lizDenny/Capstone-Flood-Monitor/README.md

# Capstone Flood Monitor
Three different licenses are used, each for different portions of the repo. Firmware and software files are covered under MIT. Hardware files like pcb and enclosure designs are covered under CERN-OHL-P-2.0. Documentation files like schematics, BOMs, and READMEs are covered under CC-BY-4.0.
