lizDenny/Capstone-Flood-Monitor/Hardware/Documentation/gpio_map.md

Raspberry Pi GPIO Allocation
Reserved
GPIO 2 - I2C SDA GPIO 3 - I2C SCL GPIO 14 - UART TX GPIO 15 - UART RX

USB Devices
USB 1 - Camera USB 2 - 

HATs
Witty Pi - Connected to 40-pin GPIO Header
