lizDenny/Capstone-Flood-Monitor/Hardware/Documentation/BillOfMaterials.xlsx

ITEM | QUANTITY | COST/UNIT | PORTS/DATA SHEET CHECKED? | LINK | NOTES
RPI 4 | 1 | $100.00 | Y | https://www.canakit.com/raspberry-pi-4-4gb.html
PV(solar panel) | 1 | $34.99 | Y | https://www.homedepot.com/p/SKYSHALO-20-Watt-12V-Solar-Panel-Charger-Solar-Battery-Maintainer-with-Smart-MPPT-Controller-and-Adjustable-Mount-2025-Update-ZJKX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 | also comes with charger
Battery pack | 1 | $99.99 | Y | https://powerwerx.com/bioenno-blf-1209a-12v-9ah-lithium-iron-pvc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
Camera** | 1 | $39.89 | Y | https://www.amazon.com/SVPRO-Outdoor-Waterproof-Surveillance-Android/dp/B07C1N9R4Z
Pressure sensor | 1 | $77.77 | Y | https://vxb.com/products/submersible-water-level-transmitter-sensor-for-liq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
3A Fuse | 5 | $0.74 | Y | https://www.digikey.com/en/products/detail/littelfuse-inc/0235003.HXP/778150?gclsrc=aw.ds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
Fuse Holder | 2 | $4.00 | Y | https://www.digikey.com/en/products/detail/littelfuse-inc/01500274Z/29453
Ultrasonic sensor | 1 | $31.12 | Y | https://www.digikey.com/en/products/detail/dfrobot/SEN0313/11202720?gclsrc=aw.ds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
12V->5V Buck Converter | 1 | $27.99 | Y | https://powerwerx.com/usbbuddy2-powerpole-usb-device-charger
20AWG Wire | 1 | $14.99 | Y | https://www.amazon.com/dp/B073QJ28ZQ?lv=shuf&channelId=500&plpRedirect=mhFallback&th=1
Modbus to USB adapter | 1 | $8.50 | Y | https://www.digikey.com/en/products/detail/dfrobot/FIT0737/13688358?gclsrc=aw.ds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
Witty Pi | 1 | $24.95 | Y | https://www.adafruit.com/product/5038
USBA to bare wire | 1 | $7.89 | Y | https://www.amazon.com/dp/B0FPRCKMNB?lv=shuf&language=zh_TW&channelId=500&plpRedirect=mhFallback
DC barrel plug to screw adapt | 1 | $2.00 | Y | https://www.digikey.com/en/products/detail/adafruit-industries-llc/369/5629435
Electrical Enclosure (no tax, free shipping) | 1 | $58.54 | Y | https://www.wistexllc.com/enclosures/amp1084ccf-allied-moulded-jic-size-junction-box-screw-cover.html
Panel for electrical enclosure | 1 | $9.94 | Y | PL108 - Allied Moulded Products - White painted carbon steel back panel for use with 10in x 8in enclosures (https://www.wistexllc.com/enclosures/pl108-10-x-8-white-painted-carbon-steel-back-panel.html)
Nylon submersible cord grips | 3 | $1.97 | Y | https://www.digikey.com/en/products/detail/american-electrical-inc/A1555-07-06/371320
1/4" 20 SS screws, nuts, washers | 5 | $8.89 | Y | https://www.amazon.com/dp/B0F2Y4ZPM6?lv=shuf&channelId=500&plpRedirect=mhFallback&th=1 |  |  |  | This is a set of 5 same amount they used on the stonefly
1/4" swivel mini ball head tripod mount | 1 | $7.99 |  | https://www.amazon.com/dp/B08M47S5CW?ref=clp_hp_h_pc&th=1
1/4" female to M6 male threaded screw adapter | 1 | $7.89 |  | https://www.amazon.com/dp/B0DQKKWFVS?plpRedirect=mhFallback&ref=clp_hp_h_pc&th=1
Velcro | 1 | $10.27 | Y | https://www.homedepot.com/p/VELCRO-30-in-Cinch-Strap-VEL-30840-USA/324636610
16-18 AWG outdoor rated cable | 1 | $25.00 | Y | https://www.homedepot.com/p/Cerrowire-50-ft-16-2-Black-Stranded-Low-Voltage-Landscape-Lighting-Wire-241-1202B/202206444
Black ABS Sheet | 1 | $5.58 | Y | https://www.amazon.com/Black-Plastic-1-Pack-Textured-Smooth/dp/B0FRSWYT3Z?sp_csd=d2lkZ2V0TmFtZT1zcF9hdGY
Heavy duty banding system | 1 | $79.96 |  | https://www.amazon.com/gp/product/B0GGZ4NR5B/ref=ox_sc_act_title_1?smid=ATVPDKIKX0DER&psc=1
Side of pole solar panel mount | 1 | $54.95 |  | https://www.digikey.com/en/products/detail/tycon-systems-inc/TPSM-10-15-SP/13919976
USB WiFi Adapter | 1 | $19.99 | Y | https://www.digikey.com/en/products/detail/sanoxy/SANOXY-300-ADPT-ANT/15780478?gclsrc=aw.ds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
SD card (128GB) | 1 | $39.43 | Y | https://www.amazon.com/SanDisk-Extreme-microSDXC-Memory-Adapter/dp/B09X7BK27V?s=electronics
*NOTES: IF ADDING TO THIS LIST, MAKE SURE TO ALSO ADD TO THE DATA SHEET. TRY TO LIMIT THE WEBSITES ORDERED FROM TO DECREASE SHIPPING COSTS WE NEED TO FIGURE OUT A QUANTITY FOR ALL SCREWS, NUTS, WASHERS
**Are buying the cam or is it going to be supplied?
 | Net Total | $851.68
 | (Total does not include shipping and taxes!)
 | Total will probably be around 110% of the gross figure ~ $825-900
 | Tax rates and shipping vary by distributor and order
 |  |  |  |  |  | Gross Total | $851.68
 | 10% tax+ship projection | $85.17 |  |  |  | Tax | $85.17
 | Gross Total projection | $936.85 |  |  |  | Remaining | $263.15
 | Remaining Funds | $263.15
