lizDenny/Capstone-Flood-Monitor/Hardware/Documentation/Schematics/power.drawio.pdf

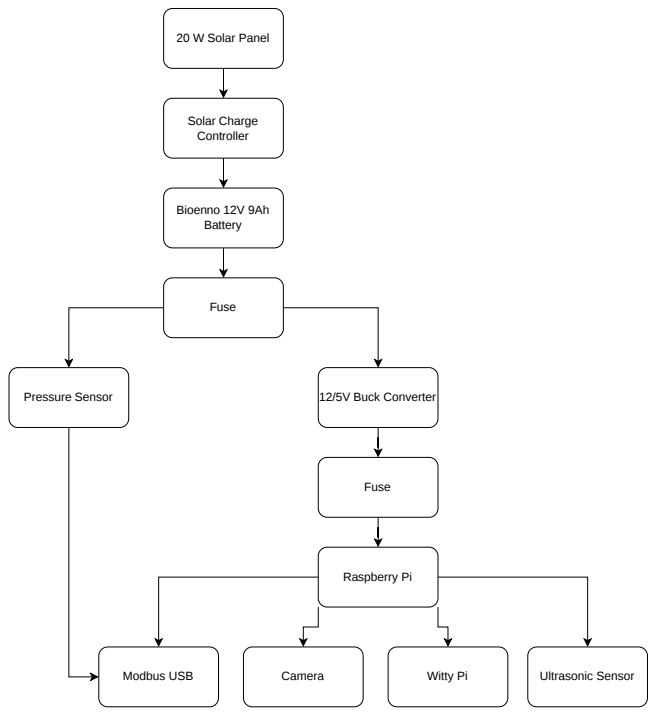
[picture p1: page 1]
20 W Solar Panel; Bioenno 12V 9Ah Battery; Solar Charge Controller; Fuse; Pressure Sensor; Raspberry Pi; Witty Pi; 12/5V Buck Converter; Modbus USB; Camera; Ultrasonic Sensor
