lizDenny/Capstone-Flood-Monitor/Hardware/Documentation/Schematics/wiring_diagram/powersystem.kicad_sch

## KiCad design Hardware/Documentation/Schematics/wiring_diagram/powersystem.kicad_sch (2026-11-09)

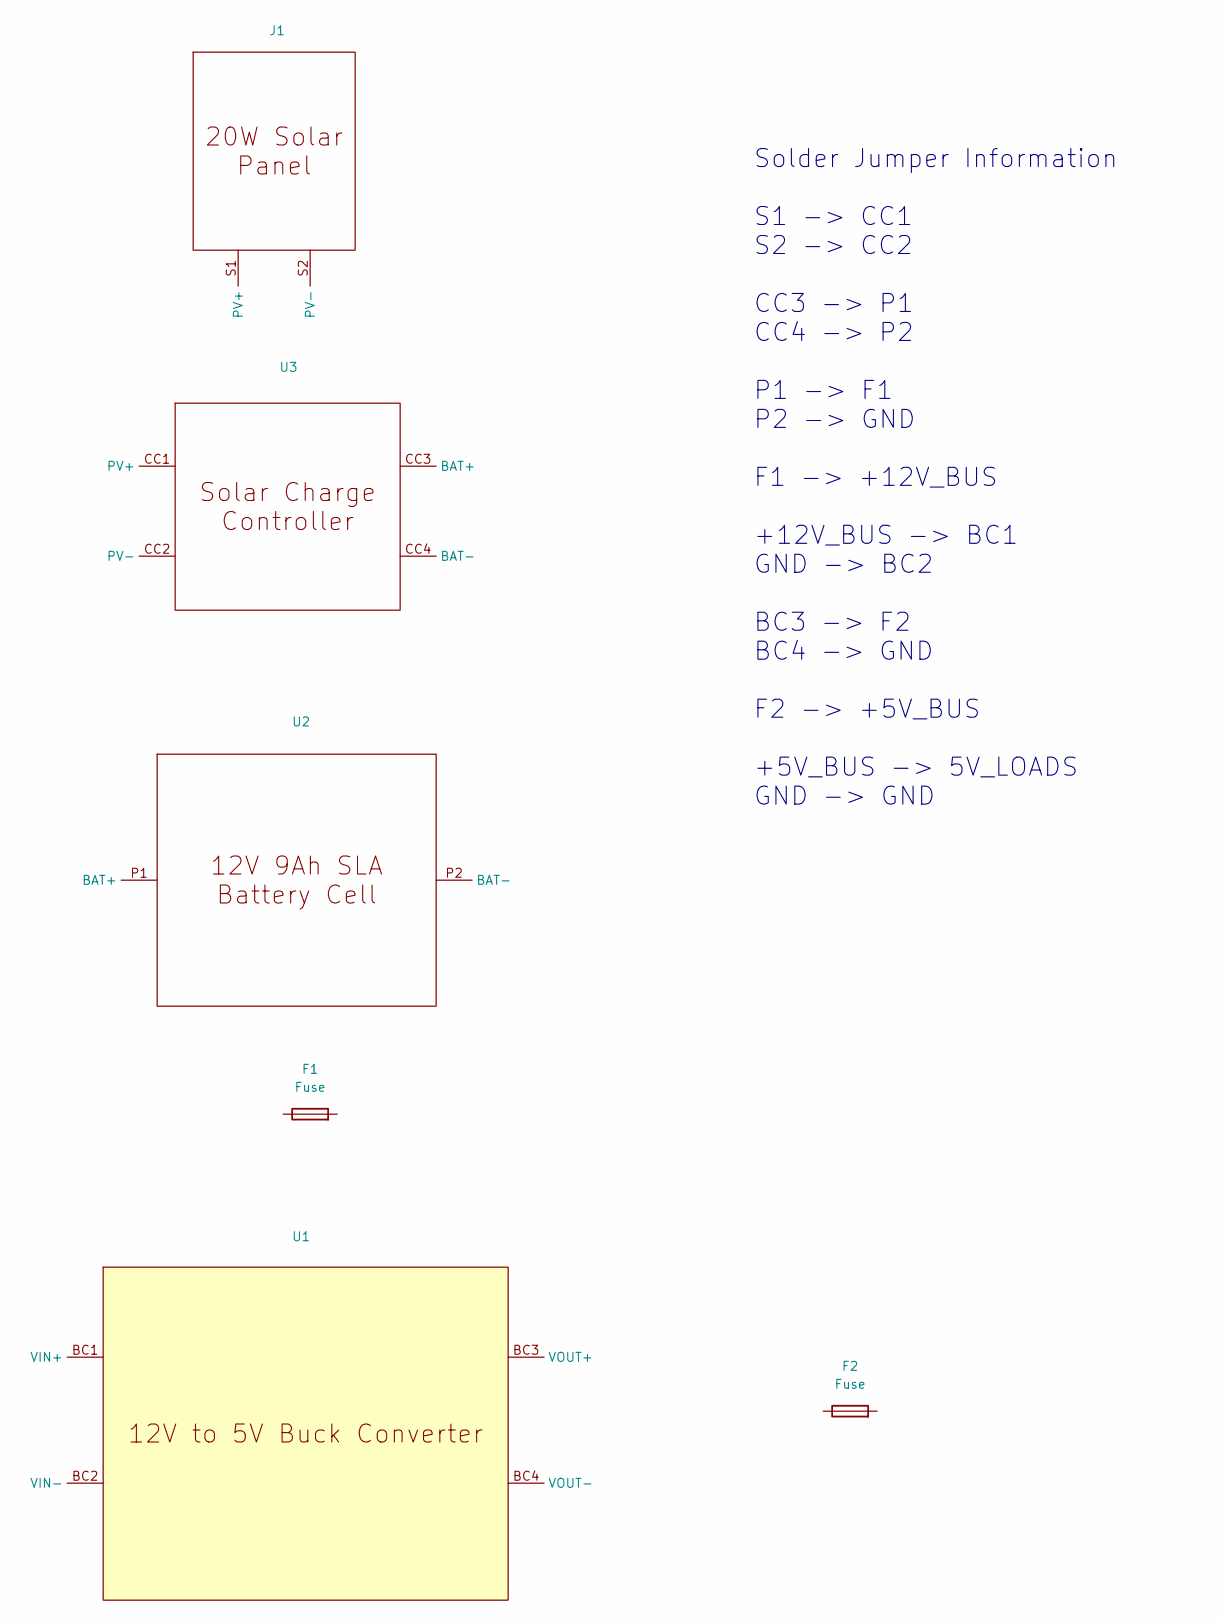
[picture p2: schematic powersystem.kicad_sch]

Parts:
F1, F2: Fuse
J1: (no value)
U1, U2, U3: (no value)

Notes on the sheet:
Solder Jumper Information S1 -> CC1 S2 -> CC2 CC3 -> P1 CC4 -> P2 P1 -> F1 P2 -> GND F1 -> +12V_BUS +12V_BUS -> BC1 GND -> BC2 BC3 -> F2 BC4 -> GND F2 -> +5V_BUS +5V_BUS -> 5V_LOADS GND -> GND
