lizDenny/Capstone-Flood-Monitor/Hardware/Documentation/Schematics/wiring_diagram/powersystem_wiring.kicad_sch

## KiCad design Hardware/Documentation/Schematics/wiring_diagram/powersystem_wiring.kicad_sch (2026-11-09)

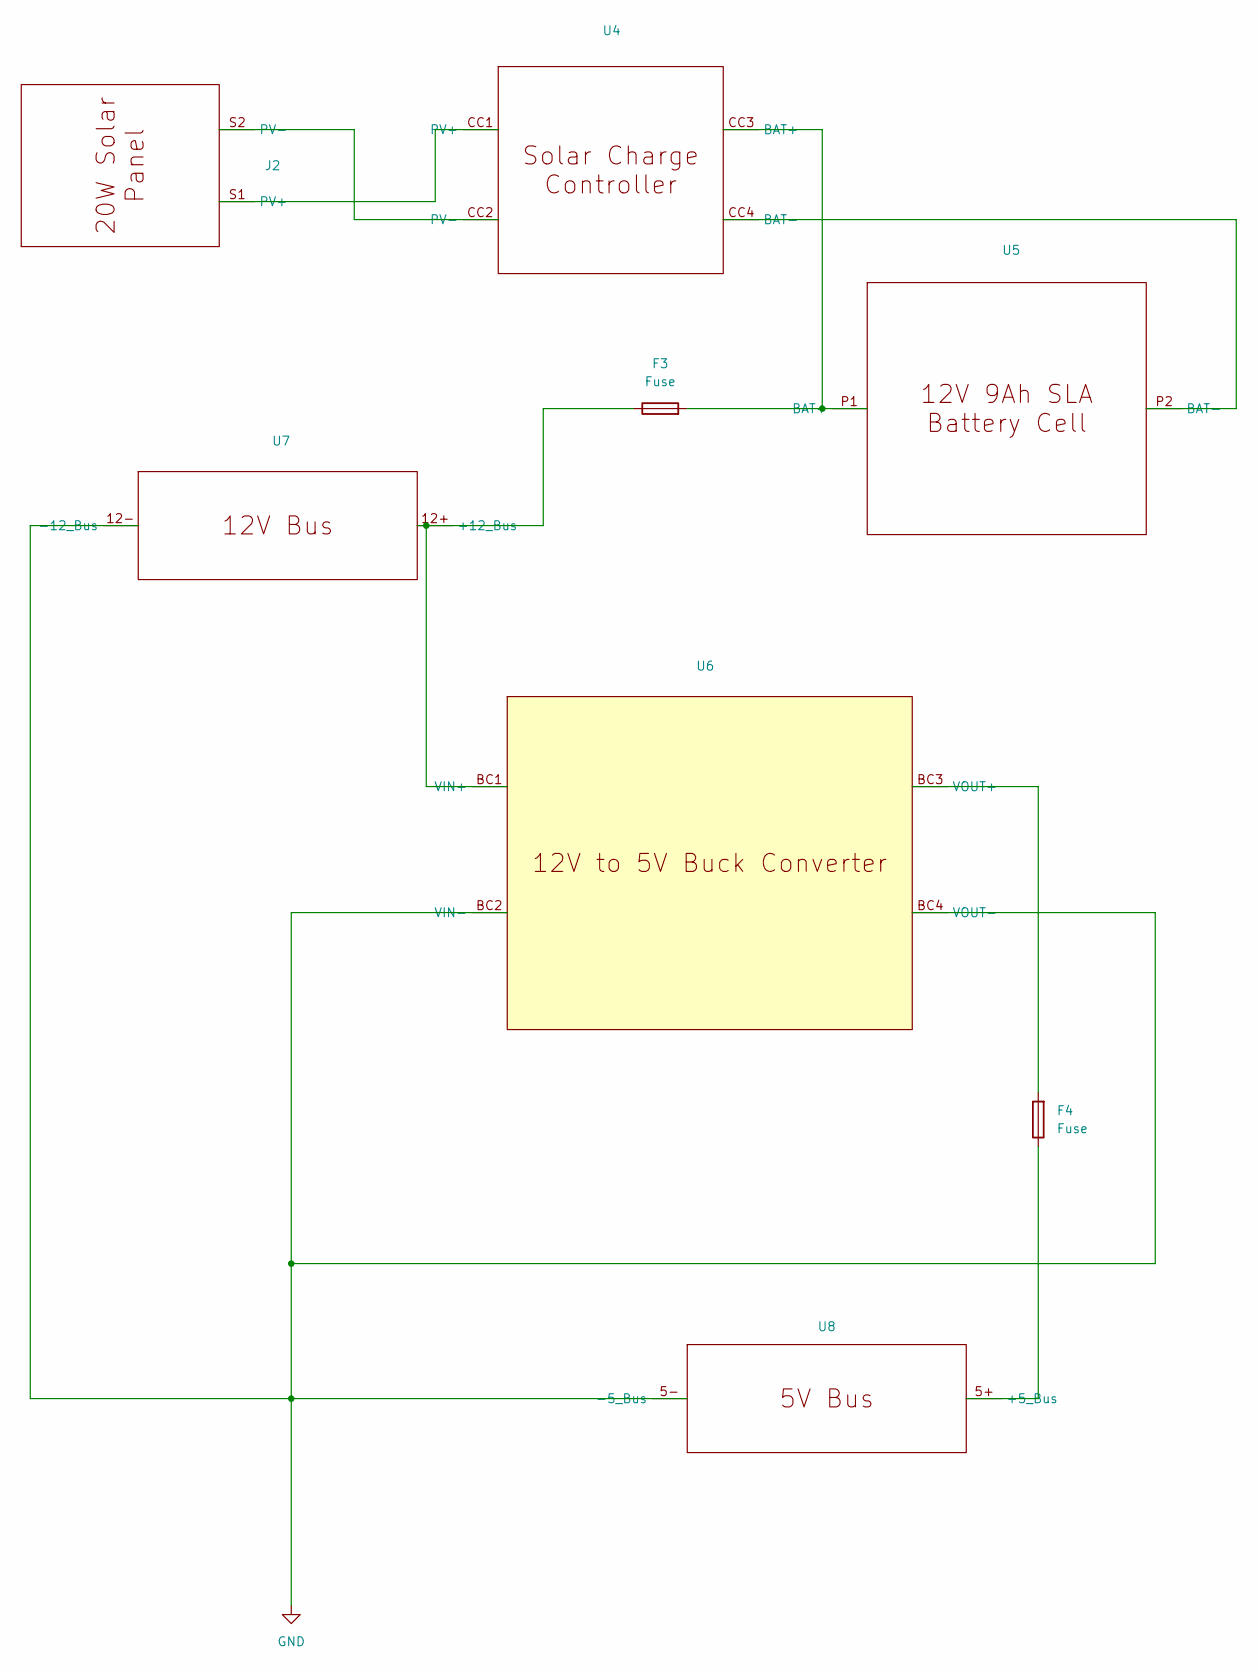
[picture p3: schematic powersystem_wiring.kicad_sch]

Parts:
F3, F4: Fuse
J2: (no value)
U4, U5, U6, U7, U8: (no value)

Connections:
GND: U6.BC2 (VIN-), U6.BC4 (VOUT-), U7.12- (-12_Bus), U8.5- (-5_Bus)
unnamed: F3.1, U6.BC1 (VIN+), U7.12+ (+12_Bus)
unnamed: F3.2, U4.CC3 (BAT+), U5.P1 (BAT+)
unnamed: F4.1, U8.5+ (+5_Bus)
unnamed: F4.2, U6.BC3 (VOUT+)
unnamed: J2.S1 (PV+), U4.CC1 (PV+)
unnamed: J2.S2 (PV-), U4.CC2 (PV-)
unnamed: U4.CC4 (BAT-), U5.P2 (BAT-)
