lizDenny/Capstone-Flood-Monitor/Firmware/TestPlan.txt

Flood Flags
  1. Pressure sensor
     Test: Give pressure data above, below, and at flag with all other flags active
     Success : The expect output is given the flags gets set or doesnt
  2. Ultrasonic sensor
     Test: Give data above, below, and at flag with all other flags active
     Success : The expect output is given the flags gets set or doesn't
