lizDenny/Capstone-Flood-Monitor/Firmware/docs/TestPlan.md

Polling Sensors + Flag Sets
  1. Pressure sensor
     Test: Give pressure data above, below, and at flag with all other flags active
     Success : The expect output is given 
  2. Ultrasonic sensor
     Test: Give data above, below, and at flag with all other flags active
     Success : The expect output is given 
  3. Camera
     Test: Give picture with or without obstruction
     Success : The expect output is given
 4. Combinations
     Test:
    
Cloud Sync

    Test: Give data to upload from all sensors
    Success: When cloud is checked data appears as it was uploaded
    
Archive Data

    Test: Give data from all sensors
    Success: When the SD car is checked data appears in correct format
