lizDenny/Capstone-Flood-Monitor/Hardware/Documentation/FailureModes.md

Dead battery
  System offline
    Battery monitoring

Solar panel damaged
  No charging
    Oversized battery

Camera failure
  No images
    Sensor health checks

Flood mode stuck on
  Excessive power use
    Software timeout

Charge controller failure
  No charging
    Voltage monitoring and alerts

Buck failure low
  Pi shuts down
    Voltage monitoring

Buck converter high
  Pi damaged
    Fuse protection

Pi freezes
  No data collection
    Automatic reboot

SD corruption
  No bootup
    Backups

False sensor readings
  Invalid measurements
    Cross-check with other sensors

Network outage
  No data transmitted
    Save internally
