lizDenny/Capstone-Flood-Monitor/(commit log)

2026-10-19 Create LICENSE.CC-BY
    Adds a third license to cover hardware documentation like schematics and BOMs.
2026-10-21 Implement code to set flags and the appropriate wakeup interval based on sensor data
2026-10-21 Create power-architecture
2026-10-25 Rename 2000424 Level Transmitter.pdf to Pressure Sensor
2026-10-26 Add import statements for sensor and cloud modules
    Added import statements for sensor polling, depth estimation, flag setting, and cloud synchronization.
2026-11-02 Expand test plan for flood flags
    Added test cases for pressure and ultrasonic sensors with expected outcomes.
2026-11-02 Update success criteria in TestPlan.txt
    Refine success criteria for pressure and ultrasonic sensor tests.
2026-11-02 Revise Test Plan to add new sensor tests
    Updated test plan to include cloud sync and archive data tests.
2026-11-06 Added blank KiCAD project for the schematic of our wiring diagram
